ZaraRuo/RobotCup_Transport_Cart/任务手册/2026补充说明_extracted.txt

2026 年度专项赛省赛赛事规则补充说明（工程竞技类赛项车型智能搬运项目）

==================================================
1、颁奖台尺寸
[示意图：见 PDF 第 1 页图1]

2、任务2 物料尺寸
[示意图：见 PDF 第 1 页图2]

3、二维码说明
二维码摆放：垂直于地面，二维码中心距地面高度为 100

==================================================
任务1 二维码对应搬运方案表
（列 A~E 为 5 个物料摆放位；行 1~16 为二维码编号）

二维码对应数字 | A | B | C | D | E
-------------- | - | - | - | - | -
 1 | 黑 | 白 | 红 | 绿 | 蓝
 2 | 白 | 黑 | 红 | 绿 | 蓝
 3 | 白 | 黑 | 绿 | 红 | 蓝
 4 | 蓝 | 白 | 黑 | 红 | 绿
 5 | 白 | 红 | 蓝 | 黑 | 绿
 6 | 黑 | 红 | 蓝 | 白 | 绿
 7 | 蓝 | 绿 | 黑 | 白 | 红
 8 | 绿 | 白 | 蓝 | 黑 | 红
 9 | 白 | 绿 | 黑 | 蓝 | 红
10 | 黑 | 红 | 蓝 | 绿 | 白
11 | 红 | 蓝 | 绿 | 黑 | 白
12 | 绿 | 红 | 黑 | 蓝 | 白
13 | 白 | 红 | 蓝 | 绿 | 黑
14 | 红 | 绿 | 白 | 蓝 | 黑
15 | 蓝 | 白 | 绿 | 红 | 黑
16 | 绿 | 蓝 | 红 | 白 | 黑

==================================================
任务2 二维码对应搬运方案表
（列 1/2/3 为三个颁奖台位置；行 1~6 为二维码编号）

二维码对应数字 | 位置1 | 位置2 | 位置3
-------------- | ----- | ----- | -----
 1 | A | B | C
 2 | A | C | B
 3 | B | A | C
 4 | B | C | A
 5 | C | A | B
 6 | C | B | A

==================================================
二维码与数字对应关系
（16 个二维码图按 4x4 排列，与数字 1~16 一一对应）

数字 | 二维码 | 数字 | 二维码 | 数字 | 二维码 | 数字 | 二维码
---- | ------ | ---- | ------ | ---- | ------ | ---- | ------
 1   | [图]   | 5    | [图]   | 9    | [图]   | 13   | [图]
 2   | [图]   | 6    | [图]   | 10   | [图]   | 14   | [图]
 3   | [图]   | 7    | [图]   | 11   | [图]   | 15   | [图]
 4   | [图]   | 8    | [图]   | 12   | [图]   | 16   | [图]
