ZaraRuo/RobotCup_Transport_Cart/(commit log)

2026-08-18 feat: add TCS230 color sensor module and fix QR scanner (auto-output mode); sync docs; add task manual
    [ColorSensor.cpp, ColorSensor.h, Config.h, QRScanner.cpp, QRScanner.h, Transport_Cart.ino]
2026-08-20 feat: complete task flow (T2+T1), turntable cell mgmt, mm tracking, segment test stages
2026-08-20 fix: double movement speed, add tracking deadband, parameterize push rod travel time, fix T2 stuck after 36deg turntable
    - Stepper: halve step interval via SPEED_BOOST to double all stepper speeds
    - Chassis: add TRACK_DEADBAND to stop continuous micro-correction and direction swinging
    - PushRod: extendToTop/retractToBottom now take travel time (20000ms)
    - TaskFlow: decouple 36deg completion, add time-slice pumping so post-scan tracking keeps speed/curve ability
    - remove build artifact Transport_Cart.zip
    [Chassis.cpp, Config.h, PushRod.cpp, PushRod.h, Stepper.cpp, TaskFlow.cpp, Transport_Cart.ino]
